finnyoun9/stm32-smart-home-ota/docs/low-power-eco-demo-plan.md

# STM32F103 Eco 低功耗最小闭环计划

> 状态：`实施中`  
> 目标：在现有 STM32F103 + FreeRTOS 环境终端中，完成一个**可测量、可重复、可解释边界**的 Eco 模式。它不是“加入低功耗 API”的教程复刻，而是验证设备在非 OTA 空闲期能按周期采样、进入 STOP、由 RTC 唤醒并恢复关键功能的完整工程闭环。

## 1. 本次范围与非目标

### 完成后的可声明事实

- 在固定硬件和供电条件下，记录 Normal 与 Eco 的电流或周期能量。
- Eco 模式会关闭明确列出的非必要负载，STM32 在非 OTA 空闲窗口进入 STOP。
- RTC 周期唤醒后，系统时钟、必要外设和应用任务恢复；串口命令与传感器快照可用。
- 连续完成至少 100 次睡眠—唤醒循环，记录成功数、失败数和复位原因。
- OTA 活跃时禁止进入 Eco，升级主链路回归通过。

### 明确不做

- 不宣称 A/B 分区、掉电自动回滚或“超低功耗”指标。
- 不在第一版同时重构 UI、ESP32 固件、任务架构或增加新传感器。
- 不把 `configUSE_TICKLESS_IDLE=1` 当作第一步；当前项目尚未实现其时基补偿与 FreeRTOS 集成验证。
- 不在没有测量数据时把 STOP 写进简历成果。

## 2. 现有约束（实现前必须保持准确）

| 约束 | 当前事实 | 对设计的影响 |
|---|---|---|
| MCU / RTOS | STM32F103C8T6、FreeRTOS，`configUSE_TICKLESS_IDLE=0` | 第一版由应用明确管理 Eco 状态，不能假称内核自动省电。 |
| 看门狗 | IWDG 约 4 秒，LSI 驱动 | 首版 RTC 睡眠窗口必须显著短于实测最短 watchdog 超时，且先做实际验证；不能直接睡 10 秒。 |
| 正常负载 | ESP32、OLED、TFT、WS2812B、I2C 传感器、继电器/蜂鸣器等 | 要区分“整机输入功耗”与“MCU/子系统功耗”；先测谁是大头再下结论。 |
| OTA | 单 Application 分区；ESP32 与 STM32 经 UART 协作 | OTA 开始到结束期间保持 Normal；不能为省电中断 UART 升级链路。 |
| RAM | 20 KB SRAM，现有应用余量有限 | 不新增大缓冲或新任务；优先复用现有状态与任务。 |

## 3. 验收工况和测量边界（先定，再写代码）

### 3.1 固定两种对比工况

| 项目 | Normal 基线 | Eco |
|---|---|---|
| STM32 | 正常时钟、现有任务正常运行 | 周期采样结束后准备 STOP，RTC 唤醒 |
| ESP32 | 固定为同一种状态（例如 Wi-Fi/蓝牙都关闭，或两者均开启） | 必须与 Normal 完全一致 |
| 显示、灯带、继电器、蜂鸣器 | 固定开关状态并记录 | 显式关闭/维持的项目逐项记录 |
| 传感器 | 固定连接、固定采样周期 | 记录哪些器件进入休眠、哪些持续供电 |
| OTA | 不进行 OTA | 不进行 OTA；另做一次 Eco 退出后 OTA 回归 |

不要在一组数据里混用不同 Wi-Fi 状态、屏幕亮度或 USB 供电。否则数据不能比较。

### 3.2 两层测量结论

1. **整机边界（必做）**：在整个终端的外部稳定电源输入处测量。它回答“用户真正用到的设备是否省电”。
2. **STM32/子系统边界（条件做）**：只有在能安全隔离 ESP32、显示和执行器供电时才测。它回答“MCU STOP 本身贡献多少”。不能隔离就明确不下 MCU 单独功耗结论。

记录表模板：

| Run | 固件 commit | 边界 | 电压 | 仪器/量程 | 工况 | 窗口 | 平均电流 | 峰值/备注 | 唤醒成功/总数 |
|---:|---|---|---:|---|---|---|---:|---|---|
| 1 | | | | | Normal | | | | — |
| 2 | | | | | Eco | | | | |

### 3.3 M0 初始测量记录（2026-09-08）

以下均为 DP100 面板稳态读数；尚未记录仪器采样率，也不用于描述唤醒瞬态。

| 边界 / 工况 | 电压 | 电流读数 | 暂定平均 | 功率 | 结论 |
|---|---:|---|---:|---:|---|
| STM32 子系统 Normal；灯带未供电 | 3.30 V | 55 / 58 / 59 mA | 57 mA | 约 0.19 W | 此边界包括同一 3.3 V 轨上已接入的主控与外设，不是裸 MCU。 |
| 5 V 支路，灯带手动固定 100% | 5.00 V | 414 / 416 / 416 mA | 415 mA | 约 2.07 W | 这是 5 V 支路总功耗，不把它全部归因于灯带。 |
| 5 V 支路，Relay 2 Off | 5.00 V | 142 / 141 mA | 约 142 mA | 约 0.71 W | 5 V 支路存在基础负载；初步排查时移除灯带 GND 后仍读 138 mA，说明该基础负载不主要来自灯带。该动作可能形成经数据线的寄生供电，不能作为正式数据。 |

在该固定工况下，灯带从 Off 到手动 100% 的**增量**约为 `415 - 142 = 273 mA`，即约 `1.36 W`。后续若要归因基础负载，应在断电后同时隔离灯带 VCC/GND，并检查继电器模块及所有共用 5 V 负载；不从当前数据推断具体器件责任。

### 3.4 M1 探针实现记录（2026-09-08）

产物：`lowpower-probe/Core/Src/main.c`，裸机单文件，`pio run -e probe` 零 warning 通过（Flash 4520 B / 6.9%，RAM 128 B / 0.6%）。

#### 测量边界的重要限制

**探针的电流数字不能与 3.3 节的 57 mA Normal 基线对比。** 57 mA 是完整主应用（OLED、TFT、BH1750、AHT20/BMP280、旋钮、PIR 全部初始化）的稳态；探针只初始化 USART1 和 RTC，清醒态电流本来就更低。两者边界不同，相减没有物理意义。

- 探针回答的问题：STOP + RTC 唤醒这条链路能否稳定工作，MCU 自身能省多少
- M2/M3 回答的问题：产品整机在非 OTA 空闲期能否省电

#### 关键设计参数

| 项目 | 取值 | 依据 |
|---|---|---|
| RTC 时钟源 | LSE 32768 Hz，`PRL=31` → 1024 Hz | LSE 已焊。启动失败自动回退 LSI（`PRL=39`，标称 1000 Hz）并在串口首行标明 |
| 睡眠窗口 | 1500 ms = 1536 tick | 见下方 IWDG 余量计算 |
| IWDG | `PR=4, RLR=2499`，与主应用逐字一致 | 探针结论可直接搬到 M2，不需重调看门狗 |
| 唤醒路径 | Alarm(ALR) → EXTI Line 17 → `RTC_Alarm_IRQn`(41) | F103 上只有这条路能唤醒 STOP |
| 调压器 | `PWR_MAINREGULATOR_ON` | 与低功耗调压器差约 10 µA，在 DP100 分辨率下不可见；主调压器唤醒更快，少一个变量 |

#### IWDG 余量（这是选 1500 ms 的原因）

IWDG 跑 LSI，**STOP 期间不停表**。LSI 数据手册范围是 30~60 kHz，不是标称的 40 kHz：

```text
标称 (40kHz): 2499 × 64 / 40000 = 4.00 s
最坏 (60kHz): 2499 × 64 / 60000 = 2.67 s   ← 按这个算余量
睡眠 1500 ms + 唤醒开销约 6 ms ≈ 1506 ms
余量: 2670 - 1506 = 1164 ms (44%)
```

所以睡眠窗口是对最坏情况 2.67 s 留 44% 余量，**不是**对标称 4 s 取一半。

#### 已确认的 F103 行为（读 HAL/CMSIS 源码核对）

- F1 的 RTC 是 32 位裸计数器，不是后续系列的 BCD 日历。`HAL_RTC_SetAlarm_IT()` 把它包装成假的 `RTC_TimeTypeDef` 来回换算，比直接写 `ALRH/ALRL` 更绕，因此 RTC 用寄存器级实现（与项目已有的寄存器级 `iwdg_init()` 风格一致）。
- F1 的 alarm 是一次性的（`stm32f1xx_hal_rtc.c:76`），每次唤醒必须重装。
- `RTC_IRQn`(3) 的 Second/Overflow 中断**无法**唤醒 STOP，只有经 EXTI17 的 Alarm 可以。
- STOP 唤醒后 SYSCLK 自动落回 HSI 8 MHz，HSE 与 PLL 关闭 → 必须重跑 `SystemClock_Config()`，且要在任何依赖时钟的操作（含 UART 波特率）之前。
- 唤醒后调 `HAL_RCC_OscConfig(HSE_ON)` 不会被 HAL 的保护分支挡住：`stm32f1xx_hal_rcc.c:368` 的 guard 只在 HSE 当前是 SYSCLK/PLL 源时报错，唤醒后是 HSI，走正常重启路径。因此可以直接复用 `SystemClock_Config()`，不需要单独写恢复函数。
- 项目里没有任何地方写 `RCC->CSR`，所以复位原因标志可信；探针读完自己清 `RMVF`。
- 进 STOP 前必须等 UART 的 **TC**（发送完成）而不只是 TXE，否则外设时钟停在半个字符中间，最后一个字节会被截断。

#### 两个正确性细节

**绝对时间调度**：`target += 1536`，而不是每次 `ALR = CNT + 1536`。后者会把唤醒延迟、时钟恢复和串口打印时间累加进间隔，导致误差逐周期漂移；前者让间隔恒等于 1536 tick，这才使 ±1 tick 的严格判定有意义。

**BKP 持久化**：唤醒数存 `BKP->DR1`、启动数 `DR2`、失败数 `DR3`、magic `DR10`。没有它，一次意外 IWDG 复位会把计数清零，就无法区分"连续 100 次"和"50 次 + 复位 + 50 次" —— 而这恰恰是 M1 的通过条件。`boots` 不增长本身就是"无意外复位"的证据。Blue Pill 无 VBAT 电池，冷启动会丢，这正是想要的区分度。

#### 实机运行步骤（未执行）

接线（**ST-Link 只接 SWDIO/SWCLK/GND，不接供电脚**，否则绕过电流测量边界）：

```bash
PA9  → USB-TTL RX     115200 8N1
GND  → USB-TTL GND    共地
PA10 不接（探针只发不收）
```

```bash
pio run -e probe -t upload    # 烧到 0x08002000，现有 bootloader 会正常引导
```

日志格式：

```text
[probe] boot rst=POR|PIN rtcsrc=LSE hz=1024 boots=1 wakes=0 fails=0
[probe] n=1 req=1500ms d=- act=- awake=5ms OK
[probe] n=2 req=1500ms d=1536t act=1500ms awake=5ms OK
```

判定：

| 检查 | 通过标准 | 失败时的第一嫌疑 |
|---|---|---|
| 时钟源 | 首行 `rtcsrc=LSE` | 若是 LSI，说明 LSE 未起振，`act=` 只能定性 |
| 进入 STOP | `act≈1500ms` | 若 `act≈0`，查 EXTI17 配置或 ALRF 未清导致中断一直 pending |
| 无意外复位 | `boots` 不增长 | 若增长且 `rst=IWDG`，说明 1500 ms 对这颗片子的 LSI 仍不够 → **缩短窗口，不是延长看门狗** |
| 100 次循环 | `wakes>=100` 且 `fails=0` | — |

日志存 `docs/captures/lowpower/`，接线照片存 `docs/photos/`。跑完后 `pio run -e app -t upload` 回主应用，确认原功能与 OTA 正常。

**M1 判定失败就停下改设计，不把 STOP 代码混进主应用。**

## 4. 电流测量：今天就能开始的安全做法

### 可用仪器的优先级

1. **台式电源带 mA 显示 / 电流记录**：最方便测整机稳态平均电流；先确认低电流量程的分辨率。
2. **万用表 DC mA 档串联**：足够做 Normal/Eco 的稳态平均值对比，但看不到毫秒级唤醒峰值。
3. **示波器 + 分流电阻**：用于观察唤醒瞬态。先从 `1 Ω`、足够功率的串联分流开始，测其两端压降，按 `I = V / R` 换算；仅在确认最大电流和供电压降可接受后使用。

USB 电流表只能作为整机粗略参考；若量程/分辨率不足，不能用它证明 STOP 的微小改善。

### 万用表串联步骤（整机基线）

1. **先完全断电。** 确认终端只有一个供电来源。
2. 将万用表黑表笔接 `COM`，红表笔先接高电流插孔并选择最高 DC 电流量程。
3. 把表**串在外部电源正极与终端 VCC 之间**：`电源 + → 万用表 A/mA → 终端 VCC`。负极/GND 保持直接相连。
4. 上电确认无异常，再逐级切换到 mA 量程以提高分辨率；切换量程前先断电，避免烧表内保险丝。
5. 每个工况等待状态稳定后，记录至少 60 秒读数；Eco 需覆盖多个睡眠/唤醒周期。

**绝不能**把电流档万用表并联在 VCC 和 GND 上；那相当于近似短路。

### ST-Link 连接注意事项

- ST-Link 只接 `SWDIO`、`SWCLK`、`GND`（需要复位调试时再接 `NRST`）；**不要接 ST-Link 的 3.3V/5V 供电脚**，否则会绕过或污染电流测量边界。
- 让被测外部电源单独给板子供电；ST-Link 的目标电压脚如仅作参考电压，按调试器实际接线确认，不把它当供电线。
- STOP 测量时不要持续单步、halt CPU 或打开会周期访问目标的调试轮询；这些操作会改变功耗和唤醒行为。需要抓日志时，让固件把结果在唤醒后通过 UART 输出。

## 5. 里程碑与产物

### M0：测量基线（先完成）

- [ ] 画出实际供电路径：外部电源、Blue Pill、ESP32、显示、传感器与执行器各由谁供电。
- [ ] 选定整机测量点，记录仪器型号、量程、供电电压和接线照片。
- [ ] 在固定 Normal 工况下完成至少 3 次 60 秒测量。
- [ ] 记录屏幕、灯带、ESP32 状态，确认哪类负载主导电流。

**进入 M1 的条件：**有一行可信的 Normal 基线数据；没有它不改低功耗代码。

### M1：最小 STOP 探针（先脱离完整 RTOS 集成）

- [x] 新增一个独立、可烧录的 F103 低功耗探针目标：RTC 定时唤醒 → STOP → 唤醒后恢复时钟 → UART 输出递增唤醒计数。
- [x] 显式记录睡眠请求时长、实际唤醒间隔和复位标志。
- [ ] 在接入 IWDG 的条件下验证至少 100 次循环不被非预期复位；若 watchdog 限制无法满足，先调整设计，不掩盖问题。
- [x] 记录 STOP 前后 SysTick、UART、时钟恢复的真实行为。

> 代码已完成并通过 `-Werror` 构建（`lowpower-probe/Core/Src/main.c`，4520 B Flash / 128 B RAM）。
> **100 次循环尚未实机运行**，因此第 3 项未打勾，M2 尚未解锁。详见 [3.4 节](#34-m1-探针实现记录2026-09-08)。

**进入 M2 的条件：**探针 100 次通过，且有串口日志/照片证明。探针失败不将 Stop 代码混入主应用。

### M2：主应用 Eco 状态机

- [ ] 定义最小状态：`NORMAL`、`ECO_PREPARE`、`ECO_SLEEP`、`ECO_RESUME`，以及一次可观测的状态/计数。
- [ ] 仅在无 OTA、无用户交互、无执行器危险状态时允许 `ECO_PREPARE`。
- [ ] 停止或降载可关闭的显示/灯带/周期轮询；每一项都要有恢复路径。
- [ ] 进入 STOP 前完成 UART 空闲与任务协作；唤醒后恢复时钟、必要外设和应用时间基准。
- [ ] 保持 OTA 活跃期间强制 Normal，并跑一次完整 OTA 回归。

**第一版睡眠窗口建议：**从明显短于约 4 秒 IWDG 标称超时的窗口开始，以实测为准；不预设节省百分比。

### M3：测量与回归

- [ ] 在 M0 的同一边界和工况，重复至少 3 次 Eco 测量。
- [ ] 做 100 次睡眠/唤醒循环，输出成功、失败和 reset cause。
- [ ] 做一次正常 UART 命令、传感器快照、显示恢复和 OTA 回归。
- [ ] 在本文件或独立报告中写清结果、失败、限制和下一步，不只保留“成功”截图。

## 6. 提交与展示标准

最终 GitHub 证据至少包括：

- 独立低功耗探针与主应用 Eco 状态机代码；
- 固件构建命令与 commit SHA；
- 实物接线/仪器照片，且可看清电流表串联位置；
- 3 组以上 Normal/Eco 数据及测试条件；
- 100 次唤醒日志或汇总；
- 已知边界：IWDG、OTA 期间禁睡、未测峰值或无法隔离的负载等。

只有 M3 完成后，才可将成果写入简历。推荐措辞保留到数据填完后再定：

> 在 STM32F103 + FreeRTOS 环境终端实现 Eco 状态机，在非 OTA 空闲期完成 RTC 唤醒、时钟/外设恢复与功能回归；基于固定负载完成 Normal/Eco 电流（或周期能量）对比，并通过 100 次唤醒循环验证稳定性。

## 7. 今天的第一小时

1. 断开 ST-Link 的供电脚，仅保留 SWD 信号与 GND；拍一张实际供电与表笔接线图。
2. 写下电源型号、输出电压、万用表型号和当前使用的电流档位。
3. 按 M0 的固定工况跑 3 次 60 秒 Normal 基线，填表，不改代码。
4. 把结果（哪怕是“表的分辨率不够”）记录到本文件。若分辨率不足，先解决测量能力，再进入 M1。
