finnyoun9/stm32-smart-home-ota/(commit log)

2026-08-23 test(ota): automate final wireless regression
2026-08-24 fix(app): disable PC13 heartbeat
    [app_tasks.h, main.c]
2026-08-30 docs: restyle README with interview content and mecanum-robot layout (#2)
    * docs: restyle README with mecanum-robot layout and add interview content
    Rebuilt on top of the current main (which had diverged after a force-push)
    instead of the stale chore/portfolio-readme branch. Restructures the README
    around a centered header, badges, a status table, and a mermaid architecture
    diagram, matching the mecanum-robot project's style. Folds in content that
    didn't exist on this base yet: why this project, the biggest technical
    challenge (WS2812B DIN/DOUT debugging), an honest AI-assisted-development
    breakdown, and interview talking points. Also updates stale details (4 tasks
    after the PC13 heartbeat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
2026-08-31 docs: add final smart-home wiring photo
2026-09-08 docs: plan measurable Eco low-power demo
2026-09-08 docs: record initial power measurements
2026-09-11 低功耗: 提交 M1 RTC → STOP → 唤醒探针实现与记录
    产物
    - lowpower-probe/Core/Src/main.c：裸机单文件，从 0x08002000 运行，
    现有 bootloader 照常引导，烧录它不触碰 bootloader
    - platformio.ini 新增 probe 环境；firmware.yml 纳入 CI；
    stlink_upload.py 适配
    关键设计
    - SLEEP_MS 1500：IWDG 走 LSI 且 STOP 期间继续计数，LSI 规格 30–60kHz
    未校准，RLR=2499 标称约 4.0s 但最坏仅约 2.67s，留 44% 余量
    - MIN_MARGIN_TICKS 8：一次 RTC 寄存器写最多花 3 个 RTCCLK 周期，
    闹钟不能设得更近，否则会错过
    - STOP 唤醒后 SYSCLK 落回 HSI 8MHz、HSE 与 PLL 关闭，需重配
    8MHz HSE → PLL×8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
2026-09-17 feat: UART DMA+IDLE、运行时可观测性、协议单一来源、边界测试矩阵
    ## UART RX: 每字节 RXNE 中断 → DMA1_CH5 循环 + USART IDLE
    - uart_comm.c/h: DMA 直接写入环形缓冲，IDLE ISR 只计算 head 增量并
    publish 到 StreamBuffer；ISR 不解析协议
    - 中断次数按协议计算：1048 次/chunk → 2 次/chunk（524x），
    115200 下从 ~11,520 次/秒降到每帧一次。证据等级=计算值，非实测
    - 回收 app 链接脚本里 1KB 废弃 libc 堆（libc 已被 /DISCARD/，无 malloc 调用）
    ## 运行时可观测性
    - 新增 CMD_DIAG_SNAPSHOT(0x33) / CMD_DIAG_SNAPSHOT_RSP(0x88) + DiagSnapshot_t(22B)
    - vMonitorTask 每 5s 采样 4 个任务的 Hi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
2026-09-17 feat(ota): 跨设备冗余恢复方案第 1-3 项 + 协议镜像彻底消除
    ## 配置区双副本 ping-pong（P0-2）
    - shared/ota_config.c 重写：每份配置占一整页（62/63），config_seq 决定胜负
    - 写入永远擦「非最新」那一页，因此中断写入不会丢配置
    （同页双副本在本硬件上不可能原子：Flash 只能整页擦除）
    - BootConfig_t 48→56B：+config_seq/boot_confirmed/boot_attempts
    - 新增 tools/ota_config_logic_test.c：23/23 断言，含「写入中断后旧副本必须胜出」
    ## 镜像 CRC 复核 + 启动确认 + 恢复窗口（P0-1/P0-3）
    - bootloader: app_image_crc_ok() 用 config 记录的 size/CRC 重算 app 区，
    识别「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
2026-09-17 feat(ota): ESP32 golden 镜像自动回滚（方案 2 第 4 项）
    ## 协议
    - 新增 CMD_RECOVERY_CHECK(0x34) / CMD_RECOVERY_RSP(0x89) / CMD_OTA_COMMITTED(0x35)
    - 修掉一个会让健康设备被误刷的撞车：原先 bootloader 用 CMD_STATUS_RSP
    返回 RECOVERY_STATUS_*（1=OTA_PENDING），而 app 用同一命令返回固件版本号，
    于是固件 v1 会被 ESP32 判成「需要恢复」。恢复状态现在有专用命令。
    - 新增 tools/recovery_protocol_test.c：237/237 断言，含上述回归与命令 ID 唯一性
    ## STM32
    - bootloader 在握手窗口与 maintenance 模式都回答 CMD_RECOVERY_CHECK
    - app 回答 CMD_RECOVERY_RSP(NORMAL)，并在启动确认后发 CMD_OT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
2026-09-27 docs: 为 shared / bootloader / application 源码补充中文注释
    纯注释改动，不改任何代码逻辑。覆盖 8 个文件：
    - shared/protocol.{h,c} 帧格式逐字节图示、命令表逐条说明、CRC 256 项表的
    生成与索引原理、九状态解析机、结构体布局约定
    - shared/ota_config.{h,c} 9 个 API 的语义与调用时机、ping-pong 选页的四种
    情况、.ramfunc 擦写原因、BKP 启动计数设计
    - bootloader/ 启动决策链七步、三档握手窗口、跳转九步
    (VTOR/MSP/PRIMASK)、两层固件校验、五场景走查表
    - application/main.c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
